ajpinar/ROUGHIE2/ROUGHIE2/ROUGHIE2_newAssemblies/UM7_BIN/README.md

UM7_BIN_v2
==========

Reads euler angles and GPS data using binary packet
