ajpinar/ROUGHIE2/Circuit Boards/Xbee_SD_etc_Shield/additionalShield.brd

## EAGLE design Circuit Boards/Xbee_SD_etc_Shield/additionalShield.brd (2015-07-09)

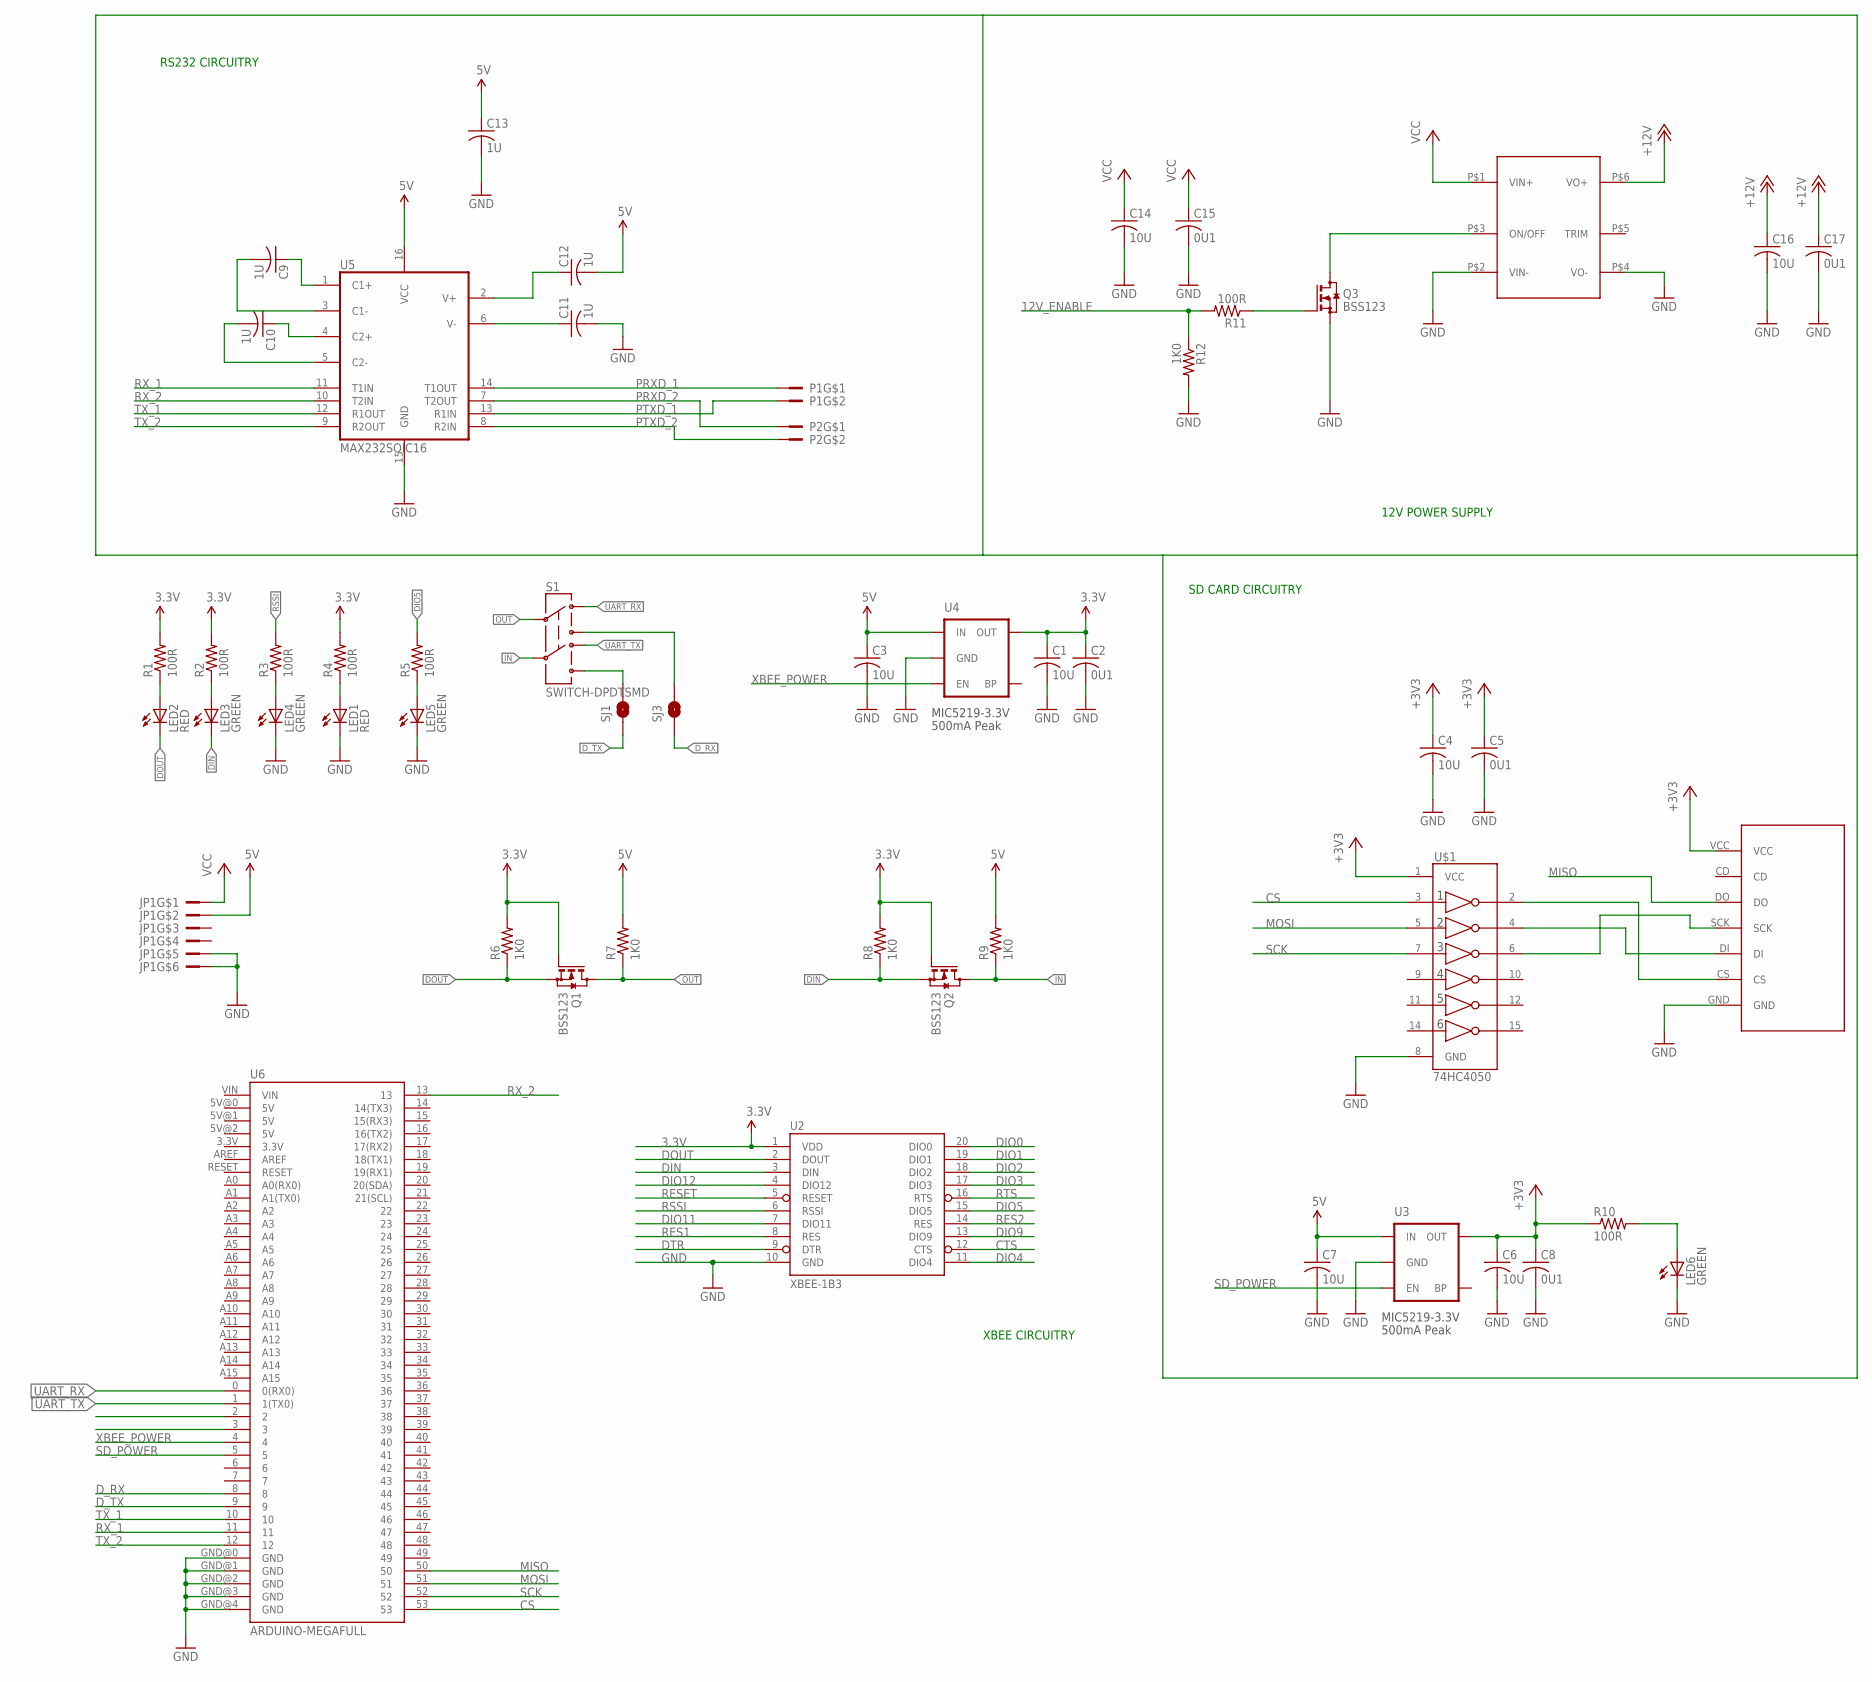
[picture p1: schematic additionalShield.sch]

Parts:
C1, C3, C4, C6, C7, C14, C16: 10U; C1210K
C2, C5, C8, C15, C17: 0U1; C1210K
C9, C10, C11, C12, C13: 1U; C1210K
JP1: 6PIN2ROWARDUINO
LED1, LED2: RED; CHIPLED_1206
LED3, LED4, LED5, LED6: GREEN; CHIPLED_1206
P1, P2: DF3A-2P-2DSA
Q1, Q2, Q3: BSS123; SOT23
R1, R2, R3, R4, R5, R10, R11: 100R; R1206
R6, R7, R8, R9, R12: 1K0; R1206
S1: SWITCH-DPDTSMD; AYZ0202
SJ1: D_TX; SJ_2S
SJ3: D_RX; SJ_2S
U2: XBEE-1B3; XBEE-SMD
U3, U4: V_REG_LDOSMD; SOT23-5
U5: MAX232SOIC16; SO016
U6: ARDUINO-MEGAFULL; ARDUINO_MEGA
U$1: 74HC4050; SO16
U$5: SD_BREAKOUT
U$11: SHHD001A3B41Z

Connections:
3.3V: C1.1, C2.1, Q1.1 (G), Q2.1 (G), R1.2, R2.2, R4.2, R6.2, R8.2, U2.1 (VDD), U4.5 (OUT)
5V: C3.1, C7.1, C12.2, C13.1, JP1.P$2, R7.2, R9.2, U3.1 (IN), U4.1 (IN), U5.16 (VCC)
12V_ENABLE: R11.2, R12.1
+3V3: C4.1, C5.1, C6.1, C8.1, R10.1, U3.5 (OUT), U$1.1 (VCC), U$5.VCC
+12V: C16.1, C17.1, U$11.P$6 (VO+)
CS: U6.53, U$1.3 (1A)
CTS: U2.12 (CTS)
DIN: LED3.C, Q2.2 (S), R8.1, U2.3 (DIN)
DIO0: U2.20 (DIO0)
DIO1: U2.19 (DIO1)
DIO2: U2.18 (DIO2)
DIO3: U2.17 (DIO3)
DIO4: U2.11 (DIO4)
DIO5: R5.2, U2.15 (DIO5)
DIO9: U2.13 (DIO9)
DIO11: U2.7 (DIO11)
DIO12: U2.4 (DIO12)
DOUT: LED2.C, Q1.2 (S), R6.1, U2.2 (DOUT)
DTR: U2.9 (DTR)
D_RX: SJ3.1, U6.8
D_TX: SJ1.1, U6.9
GND: C1.2, C2.2, C3.2, C4.2, C5.2, C6.2, C7.2, C8.2, C11.2, C13.2, C14.2, C15.2, C16.2, C17.2, JP1.P$5, JP1.P$6, LED1.C, LED4.C, LED5.C, LED6.C, Q3.2 (S), R12.2, U2.10 (GND), U3.2 (GND), U4.2 (GND), U5.15 (GND), U6.GND@0 (GND), U6.GND@1 (GND), U6.GND@2 (GND), U6.GND@3 (GND), U6.GND@4 (GND), U$1.8 (GND), U$5.GND, U$11.P$2 (VIN-), U$11.P$4 (VO-)
IN: Q2.3 (D), R9.1, S1.5
MISO: U6.50, U$5.DO
MOSI: U6.51, U$1.5 (2A)
unnamed: LED2.A, R1.1
unnamed: LED4.A, R3.1
unnamed: LED3.A, R2.1
unnamed: LED6.A, R10.2
unnamed: U$1.2 (1Y), U$5.CS
unnamed: U$1.4 (2Y), U$5.DI
unnamed: U$1.6 (3Y), U$5.SCK
unnamed: C9.1, U5.1 (C1+)
unnamed: C9.2, U5.3 (C1-)
unnamed: C10.1, U5.4 (C2+)
unnamed: C10.2, U5.5 (C2-)
unnamed: C11.1, U5.6 (V-)
unnamed: C12.1, U5.2 (V+)
unnamed: Q3.1 (G), R11.1
unnamed: Q3.3 (D), U$11.P$3 (ON/OFF)
unnamed: LED1.A, R4.1
unnamed: LED5.A, R5.1
unnamed: S1.6, SJ1.2
unnamed: S1.3, SJ3.2
OUT: Q1.3 (D), R7.1, S1.2
PRXD_1: P1.P$1, U5.14 (T1OUT)
PRXD_2: P2.P$1, U5.7 (T2OUT)
PTXD_1: P1.P$2, U5.13 (R1IN)
PTXD_2: P2.P$2, U5.8 (R2IN)
RES1: U2.8 (RES)
RES2: U2.14 (RES)
RESET: U2.5 (RESET)
RSSI: R3.2, U2.6 (RSSI)
RTS: U2.16 (RTS)
RX_1: U5.11 (T1IN), U6.11
RX_2: U5.10 (T2IN), U6.13
SCK: U6.52, U$1.7 (3A)
SD_POWER: U3.3 (EN), U6.5
TX_1: U5.12 (R1OUT), U6.10
TX_2: U5.9 (R2OUT), U6.12
UART_RX: S1.1, U6.0 (0(RX0))
UART_TX: S1.4, U6.1 (1(TX0))
VCC: C14.1, C15.1, JP1.P$1, U$11.P$1 (VIN+)
XBEE_POWER: U4.3 (EN), U6.4

Notes on the sheet:
500mA Peak
MIC5219-3.3V
XBEE CIRCUITRY
12V POWER SUPPLY
SD CARD CIRCUITRY
RS232 CIRCUITRY

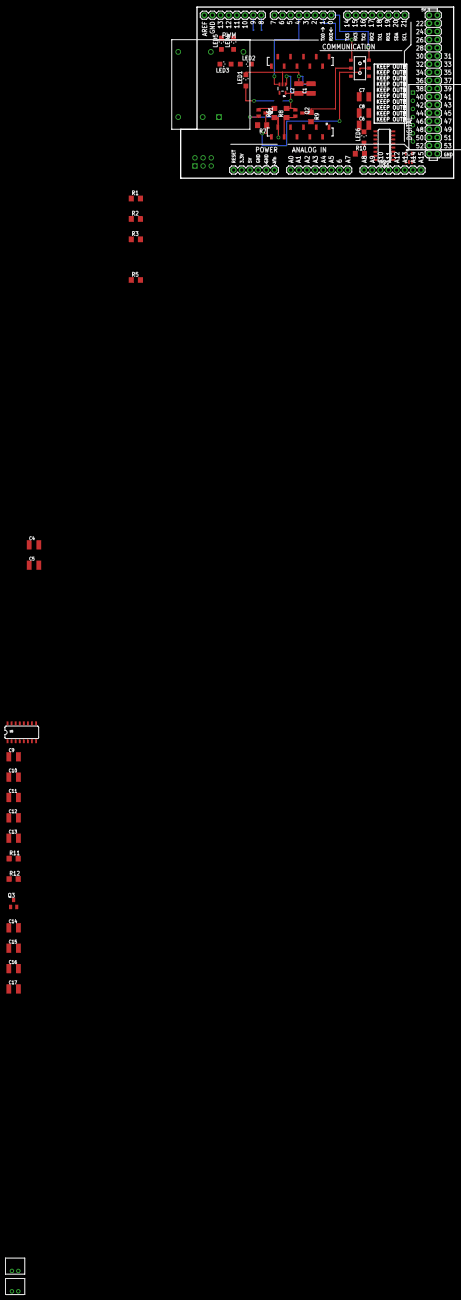
[picture p2: board additionalShield.brd from above]

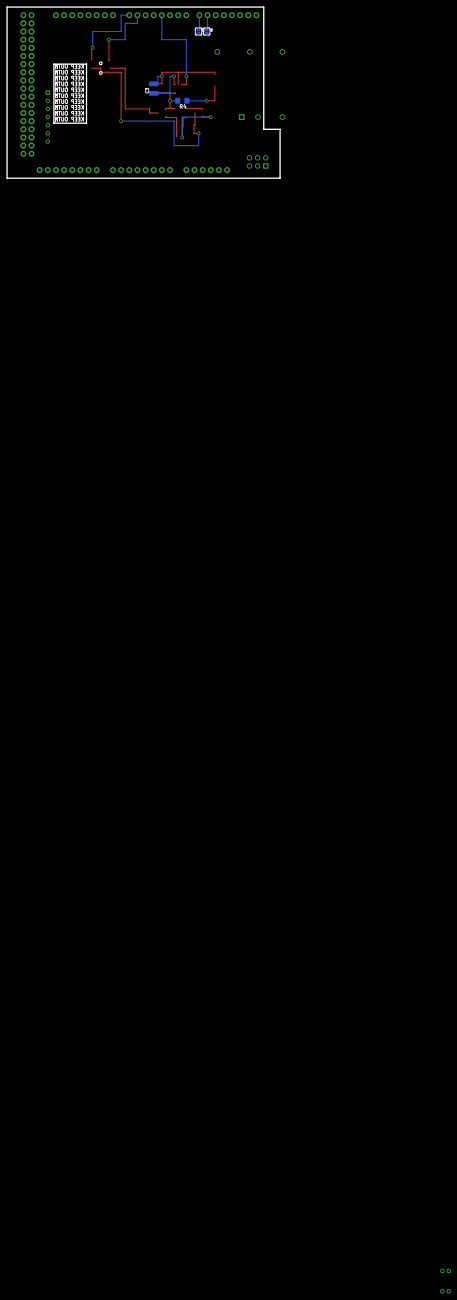
[picture p3: board additionalShield.brd from below]

Board: 2 copper layers, 85.1 x 53.3 mm, 52 parts (4 on the bottom side), 50 nets.
