ajpinar/ROUGHIE2/Circuit Boards/UpdatedMainBoard/CntrlBoard.brd

## EAGLE design Circuit Boards/UpdatedMainBoard/CntrlBoard.brd (2015-06-10)

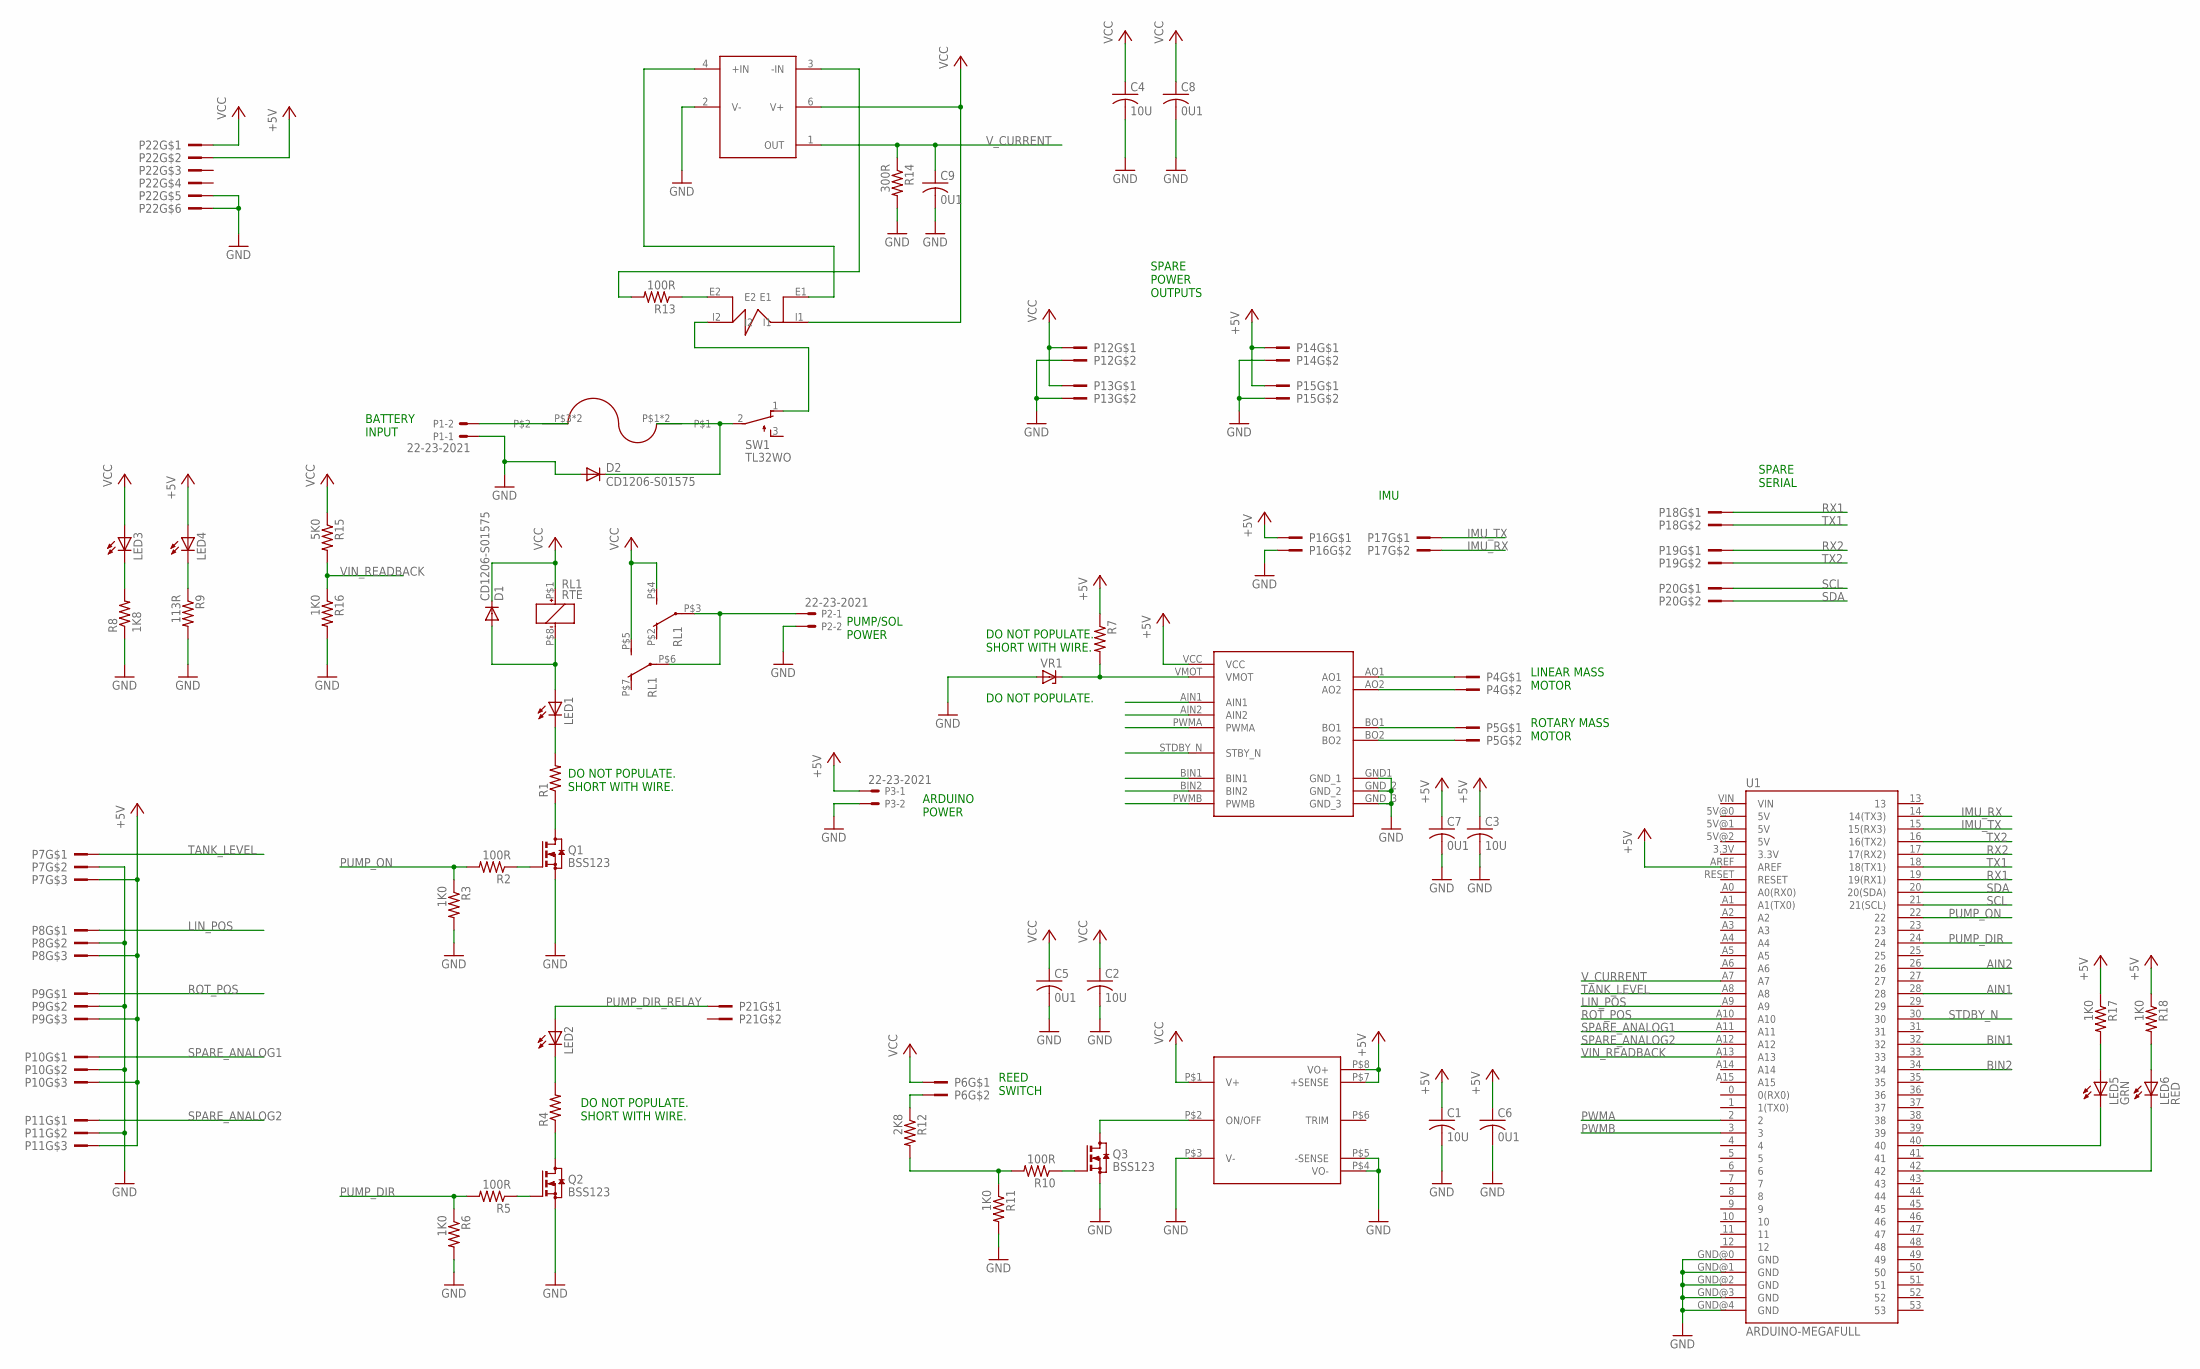
[picture p4: schematic CntrlBoard.sch]

Parts:
C1, C2, C3, C4: 10U; C1210K
C5, C6, C7, C8, C9: 0U1; C1210K
D1, D2: CD1206-S01575; CD1206
LED1, LED2, LED3, LED4: LEDCHIPLED_1206; CHIPLED_1206
LED5: GRN; CHIPLED_1206
LED6: RED; CHIPLED_1206
P1, P2, P3: 22-23-2021
P4, P5, P6, P12, P13, P14, P15, P16, P17, P18, P19, P20, P21: DF3A-2P-2DSA
P7, P8, P9, P10, P11: 3MM2MMLOCKING; 3PIN_2MMLOCKING
P22: 6PIN2ROWARDUINO
PS1: KHHD006A0A41Z
Q1, Q2, Q3: BSS123; SOT23
R1, R4, R7: R-US_R1206; R1206
R2, R5, R10, R13: 100R; R1206
R3, R6, R11, R16, R17, R18: 1K0; R1206
R8: 1K8; R1210
R9: 113R; R1206
R12: 2K8; R1206
R14: 300R; R1206
R15: 5K0; R1206
RL1: RTE
SW1: TL32WO; TL3XWO
U1: ARDUINO-MEGAFULL; ARDUINO_MEGA
U$1: ATC_FUSE_HOLDER; FUSE_HOLDER_ATC
U$2: POLOLU713
U$3: RSHUNT; CM2512SHUNT
U$4: LT6106; TSOT23-6
VR1: ZENER-DIODESOT23; SOT23

Connections:
+5V: C1.1, C3.1, C6.1, C7.1, LED4.A, P3.1, P7.P$3, P8.P$3, P9.P$3, P10.P$3, P11.P$3, P14.P$1, P15.P$1, P16.P$1, P22.P$2, PS1.P$7 (+SENSE), PS1.P$8 (VO+), R7.1, R17.1, R18.1, U1.AREF, U$2.VCC
AIN1: U1.28, U$2.AIN1
AIN2: U1.26, U$2.AIN2
BIN1: U1.32, U$2.BIN1
BIN2: U1.34, U$2.BIN2
GND: C1.2, C2.2, C3.2, C4.2, C5.2, C6.2, C7.2, C8.2, C9.2, D2.A, P1.1, P2.2, P3.2, P7.P$2, P8.P$2, P9.P$2, P10.P$2, P11.P$2, P12.P$2, P13.P$2, P14.P$2, P15.P$2, P16.P$2, P22.P$5, P22.P$6, PS1.P$3 (V-), PS1.P$4 (VO-), PS1.P$5 (-SENSE), Q1.2 (S), Q2.2 (S), Q3.2 (S), R3.2, R6.2, R8.1, R9.2, R11.2, R14.2, R16.2, U1.GND@0 (GND), U1.GND@1 (GND), U1.GND@2 (GND), U1.GND@3 (GND), U1.GND@4 (GND), U$2.GND1 (GND_1), U$2.GND_2, U$2.GND_3, U$4.2 (V-), VR1.1 (A)
IMU_RX: P17.P$2, U1.14 (14(TX3))
IMU_TX: P17.P$1, U1.15 (15(RX3))
LIN_POS: P8.P$1, U1.A9
unnamed: P1.2, U$1.P$3, U$1.P$4
unnamed: D1.A, LED1.A, RL1.P$8 (-)
unnamed: LED5.C, U1.40
unnamed: P2.1, RL1.P$3, RL1.P$6
unnamed: LED1.C, R1.2
unnamed: Q1.3 (D), R1.1
unnamed: Q2.3 (D), R4.1
unnamed: Q1.1 (G), R2.1
unnamed: LED2.C, R4.2
unnamed: LED4.C, R9.1
unnamed: Q2.1 (G), R5.1
unnamed: LED3.C, R8.2
unnamed: R10.2, R11.1, R12.2
unnamed: Q3.1 (G), R10.1
unnamed: P6.P$2, R12.1
unnamed: PS1.P$2 (ON/OFF), Q3.3 (D)
unnamed: P4.P$1, U$2.AO1
unnamed: P4.P$2, U$2.AO2
unnamed: P5.P$1, U$2.BO1
unnamed: P5.P$2, U$2.BO2
unnamed: R7.2, U$2.VMOT, VR1.3 (C)
unnamed: SW1.1 (O), U$3.I2
unnamed: LED6.C, U1.42
unnamed: R13.1, U$3.E2
unnamed: R13.2, U$4.3 (-IN)
unnamed: U$3.E1, U$4.4 (+IN)
unnamed: D2.K (C), SW1.2, U$1.P$1, U$1.P$2
unnamed: LED5.A, R17.2
unnamed: LED6.A, R18.2
PUMP_DIR: R5.2, R6.1, U1.24
PUMP_DIR_RELAY: LED2.A, P21.P$1
PUMP_ON: R2.2, R3.1, U1.22
PWMA: U1.2, U$2.PWMA
PWMB: U1.3, U$2.PWMB
ROT_POS: P9.P$1, U1.A10
RX1: P18.P$1, U1.19 (19(RX1))
RX2: P19.P$1, U1.17 (17(RX2))
SCL: P20.P$1, U1.21 (21(SCL))
SDA: P20.P$2, U1.20 (20(SDA))
SPARE_ANALOG1: P10.P$1, U1.A11
SPARE_ANALOG2: P11.P$1, U1.A12
STDBY_N: U1.30, U$2.STDBY_N (STBY_N)
TANK_LEVEL: P7.P$1, U1.A8
TX1: P18.P$2, U1.18 (18(TX1))
TX2: P19.P$2, U1.16 (16(TX2))
VCC: C2.1, C4.1, C5.1, C8.1, D1.K (C), LED3.A, P6.P$1, P12.P$1, P13.P$1, P22.P$1, PS1.P$1 (V+), R15.1, RL1.P$1 (+), RL1.P$4 (S), RL1.P$5 (S), U$3.I1, U$4.6 (V+)
VIN_READBACK: R15.2, R16.1, U1.A13
V_CURRENT: C9.1, R14.1, U1.A7, U$4.1 (OUT)

Notes on the sheet:
BATTERY INPUT
PUMP/SOL POWER
DO NOT POPULATE. SHORT WITH WIRE.
ARDUINO POWER
REED SWITCH
LINEAR MASS MOTOR
ROTARY MASS MOTOR
DO NOT POPULATE.
SPARE POWER OUTPUTS
IMU
SPARE SERIAL

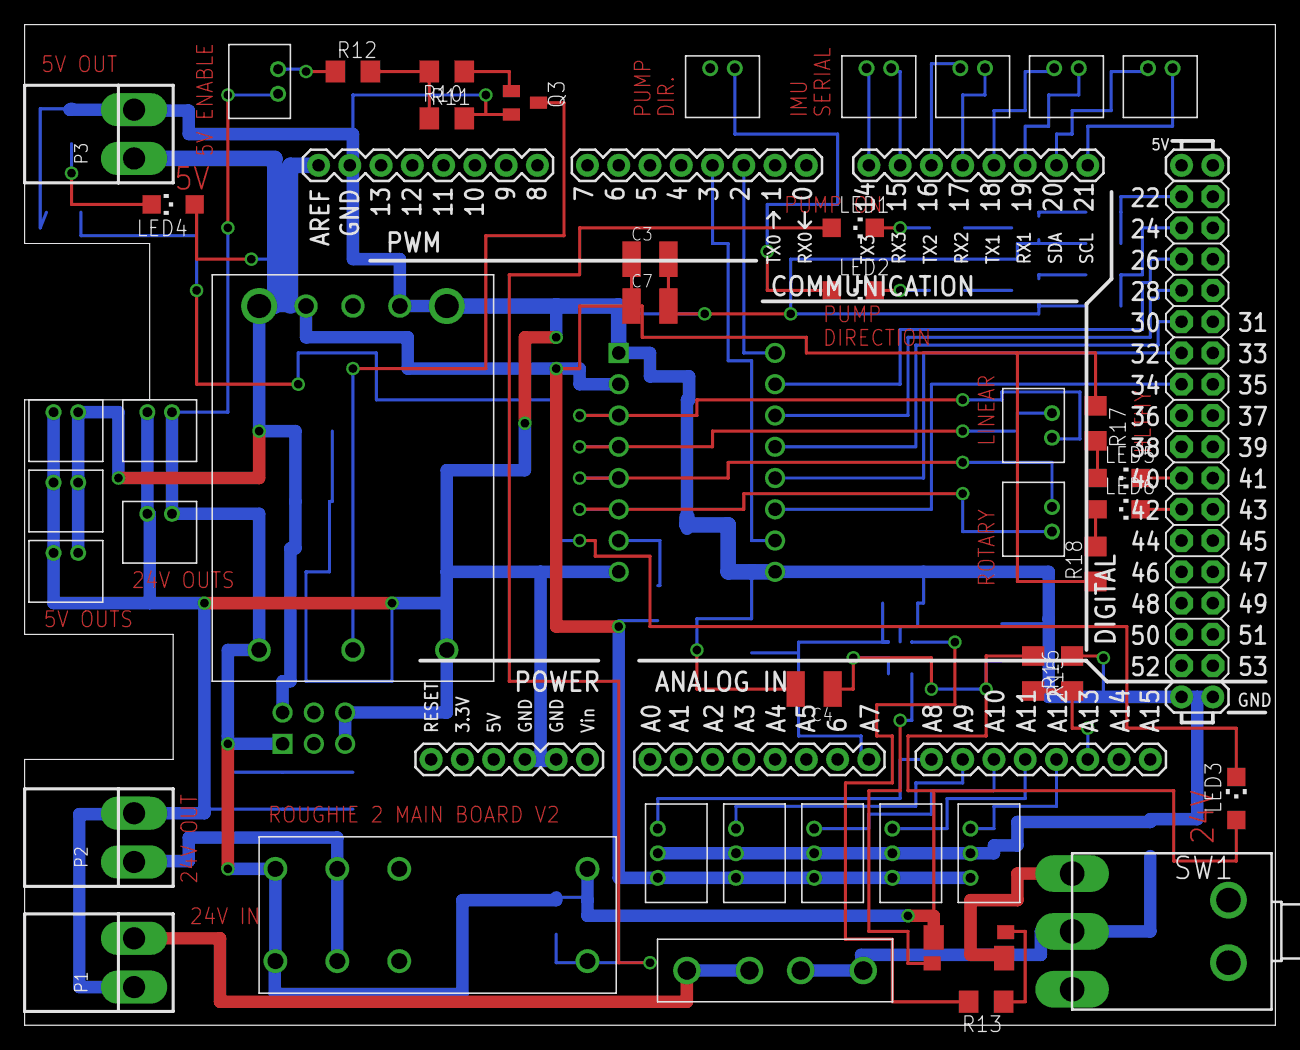
[picture p5: board CntrlBoard.brd from above]

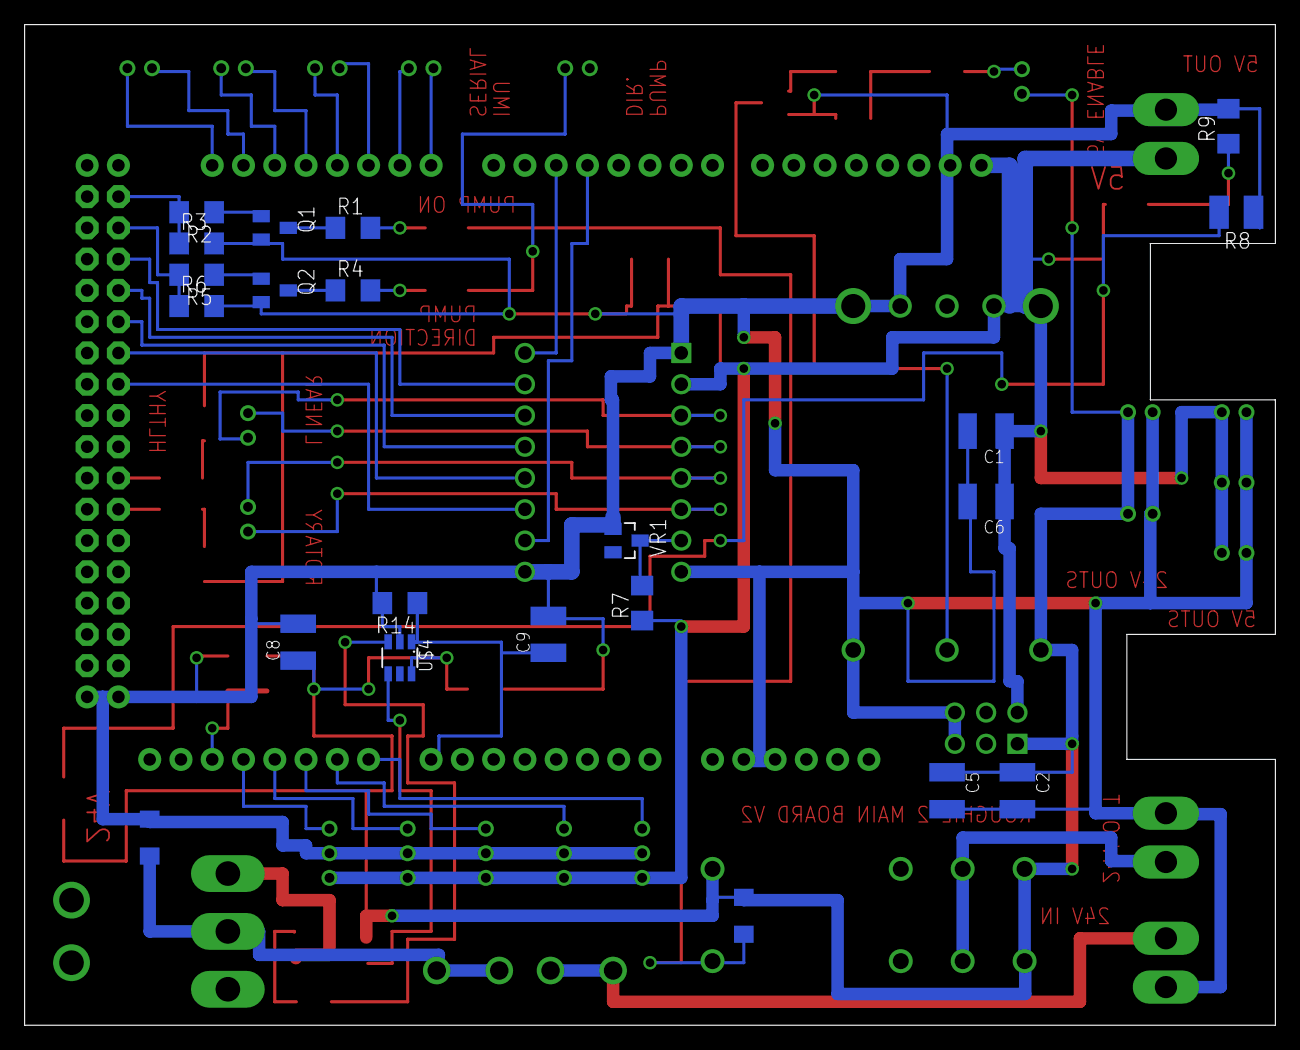
[picture p6: board CntrlBoard.brd from below]

Board: 2 copper layers, 101.6 x 81.3 mm, 69 parts (22 on the bottom side), 57 nets.
