ajpinar/ROUGHIE2/Circuit Boards/BasicBoards/PumpSolBoardV2.brd

## EAGLE design Circuit Boards/BasicBoards/PumpSolBoardV2.brd (2015-06-04)

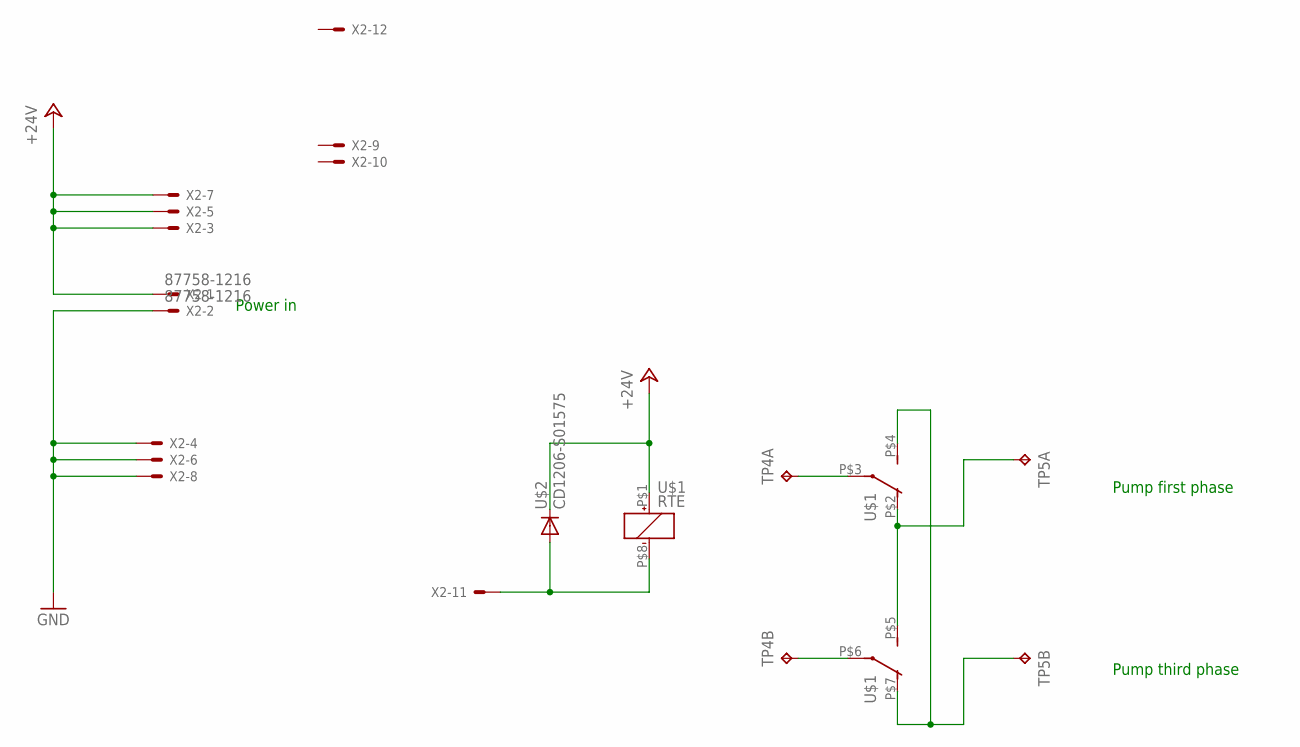
[picture p7: schematic PumpSolBoardV2.sch]

Parts:
TP4, TP5: TP2P2-38-20; P2-38-20
U$1: RTE
U$2: CD1206-S01575; CD1206
X2: 87758-1216

Connections:
+24V: U$1.P$1 (+), U$2.K (C), X2.1, X2.3, X2.5, X2.7
GND: X2.2, X2.4, X2.6, X2.8
unnamed: U$1.P$8 (-), U$2.A, X2.11
unnamed: TP5.TP-1, U$1.P$2 (O), U$1.P$5 (S)
unnamed: TP5.TP-2, U$1.P$4 (S), U$1.P$7 (O)
unnamed: TP4.TP-1, U$1.P$3
unnamed: TP4.TP-2, U$1.P$6

Notes on the sheet:
Pump first phase
Pump third phase
Power in

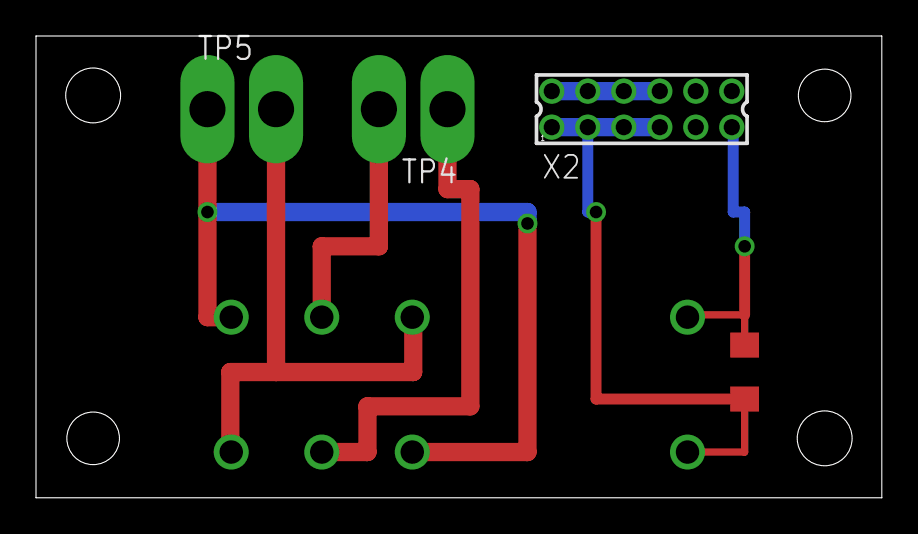
[picture p8: board PumpSolBoardV2.brd from above]

Board: 2 copper layers, 47.0 x 25.7 mm, 5 parts (1 on the bottom side), 7 nets.
