ajpinar/ROUGHIE2/(commit log)

2015-03-25 Roll code bench tested outside of hull
    This is enough code to complete a benchtest of the roll mechanism. We
    can use it to test inside the hull when we’re ready.
2015-06-02 Updated for new circuitry
2015-06-04 Bench tested for V2 of circuitry
2015-06-04 Added Eagle files
    [CntrlBoard.brd, CntrlBoard.sch, PumpSolBoardV2.brd, PumpSolBoardV2.sch]
2015-06-05 Added UpdatesToDo file
    Contains ideas for upgrades to the circuit boards
2015-06-06 Organized & started XBee
    Added new folder for updated control board development (updated control
    board is the Basic board + XBee capability & maybe other improvements
    [CntrlBoard.brd, CntrlBoard.sch, PumpSolBoardV2.brd, PumpSolBoardV2.sch, Xbee_shield_v15.brd, Xbee_shield_v15.sch]
2015-06-06 Added updates 3, 4, 6, and 9 from UpdatesToDo.txt
    [CntrlBoard.brd]
2015-06-07 Control Board update finished
    [CntrlBoard.brd, CntrlBoard.sch, Xbee_shield_v15.brd, Xbee_shield_v15.sch]
2015-06-07 Added 6 pin connector
    [CntrlBoard.brd, CntrlBoard.sch]
2015-06-10 Updated main board again
    [CntrlBoard.brd, CntrlBoard.sch, Xbee_shield_v15.brd, Xbee_shield_v15.sch]
2015-07-02 added UM7BIN
    [Xbee_shield_v15.brd, Xbee_shield_v15.sch, additionalShield.brd, additionalShield.sch]
2015-07-07 Got SD commands fully working (no glider attached)
2015-07-09 got code working again
    [additionalShield.brd, additionalShield.sch]
2015-07-20 Started pressure control code
2015-07-21 modified timers
    Put ME_NOSE_UP and ME_NOSE_DOWN inside timers
2015-07-24 updated des/rise time and # cycles
2015-07-24 Added log files from Jul 23 test
    [7_23_2015_LOG1.CSV, 7_23_2015_LOG2.CSV, 7_23_2015_LOG3.CSV, 7_23_2015_LOG4.CSV, 7_23_2015_LOG5.CSV]
2015-07-24 added 7/23 logs
    [7_23_2015_LOG1.CSV, 7_23_2015_LOG1_modified.CSV, 7_23_2015_LOG2.CSV, 7_23_2015_LOG3.CSV, 7_23_2015_LOG4.CSV, 7_23_2015_LOG5.CSV]
2015-09-03 fixed timer thing
2015-09-13 Fixed feedforward, still needs benchtest
    [ROUGHIE2_RotaryAdded.ino]
2015-09-17 Removed dynamical stuff and updated to use HiTec servo
2015-09-23 Added new UM7 library, gimme command, and fixed datalogger
    [ROUGHIE2.ino]
2015-09-24 Removed <3> error printout
    [ROUGHIE2.ino]
2015-12-10 swapped roll and pitch
    [ROUGHIE2_newAssemblies.ino, basic.ino, gliderMotion.ino]
